Shingyy/MAC-Array-based-DNN-Accelerator/Activation Buffer/rtl_schematic/Ekran görüntüsü 2026-07-28 130544.png

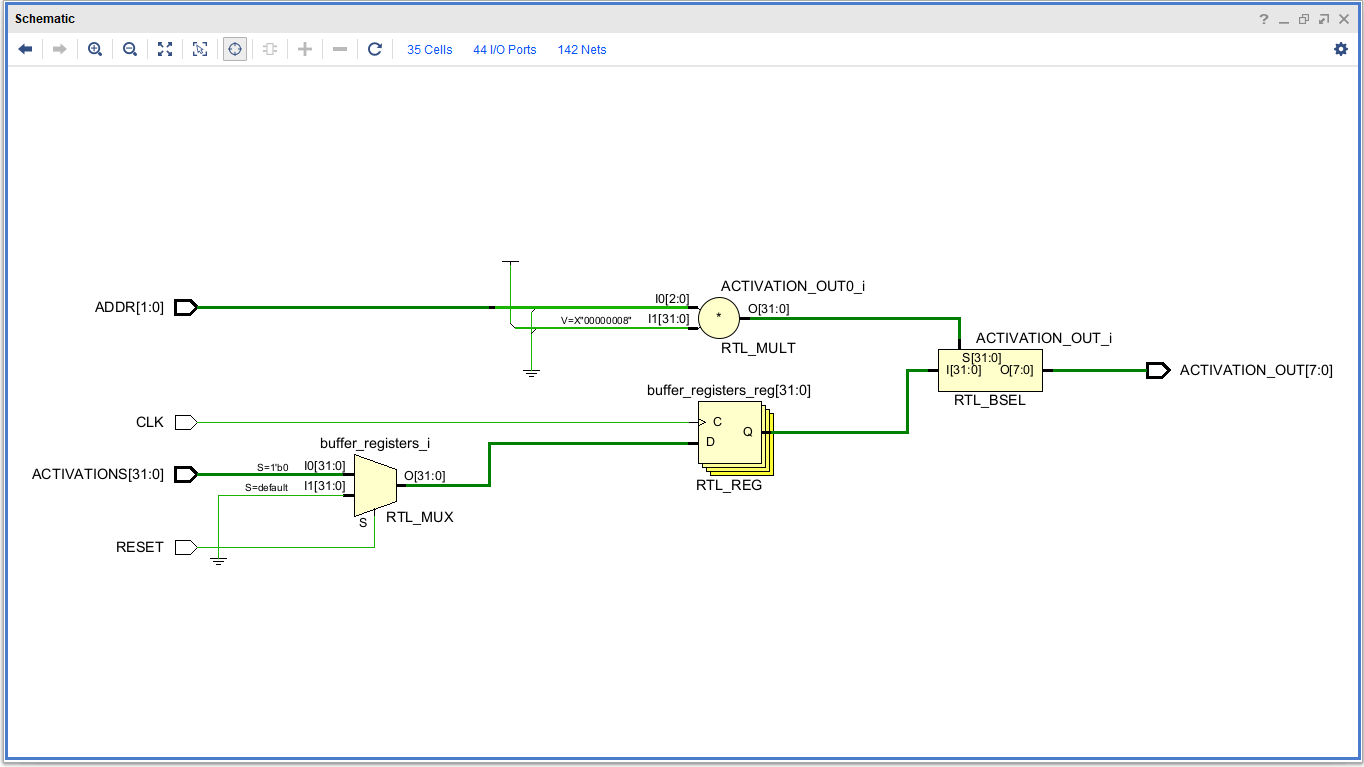
Activation Buffer/rtl_schematic/Ekran görüntüsü 2026-07-28 130544.png
