Shingyy/MAC-Array-based-DNN-Accelerator/Activation FIFO/rtl_schematic/Ekran görüntüsü 2026-07-28 144858.png

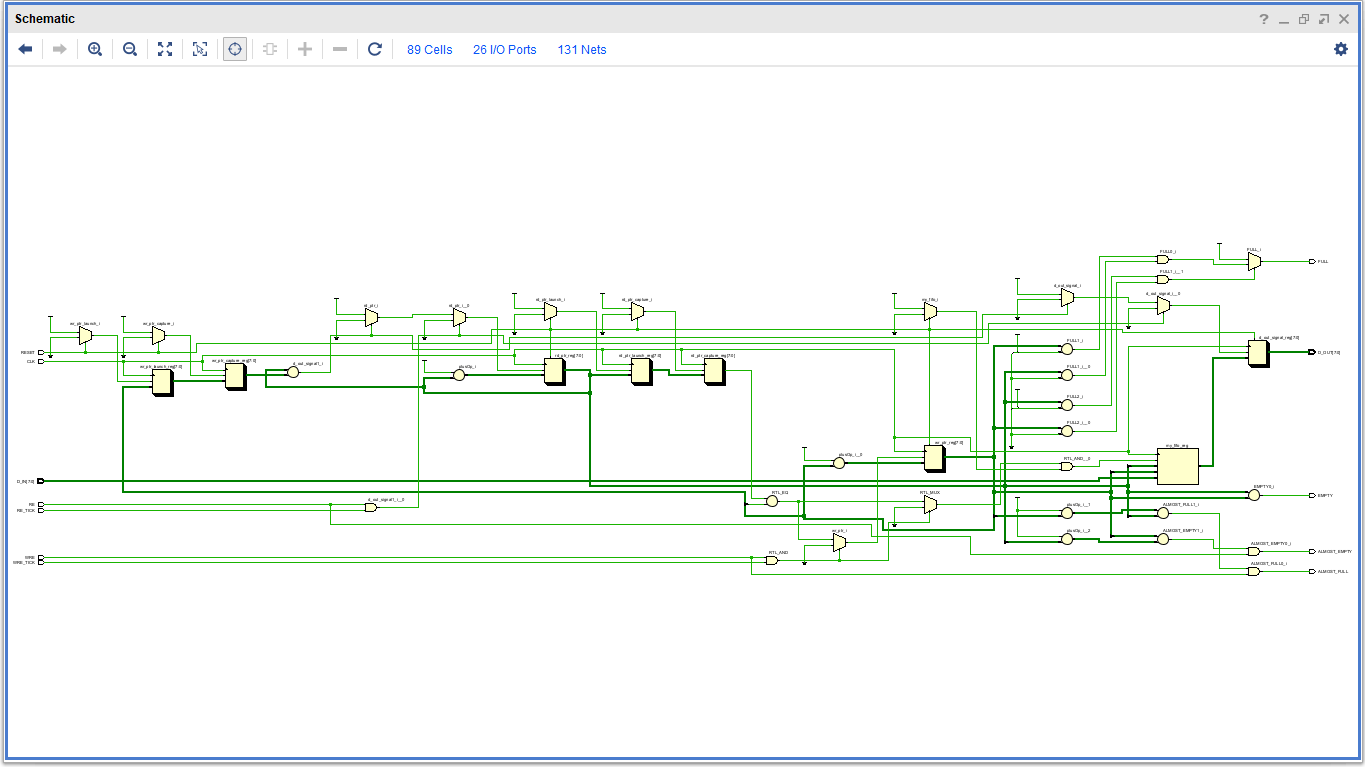
Activation FIFO/rtl_schematic/Ekran görüntüsü 2026-07-28 144858.png
