Shingyy/MAC-Array-based-DNN-Accelerator/Input Features Buffer/rtl_schematic/input_buffer_connected_to_MACU.png

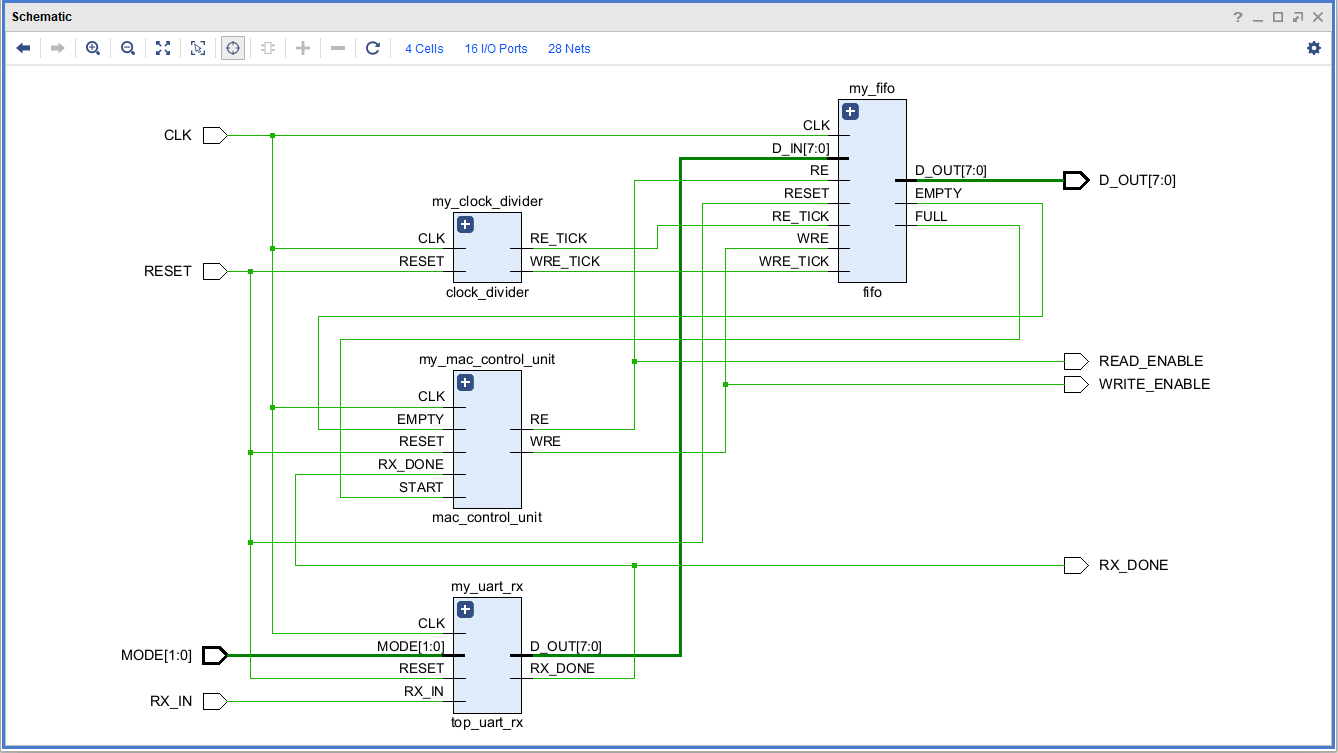
Input Features Buffer/rtl_schematic/input_buffer_connected_to_MACU.png
