Shingyy/MAC-Array-based-DNN-Accelerator/MAC Array Control Unit/state diagram/state diagram.jpeg

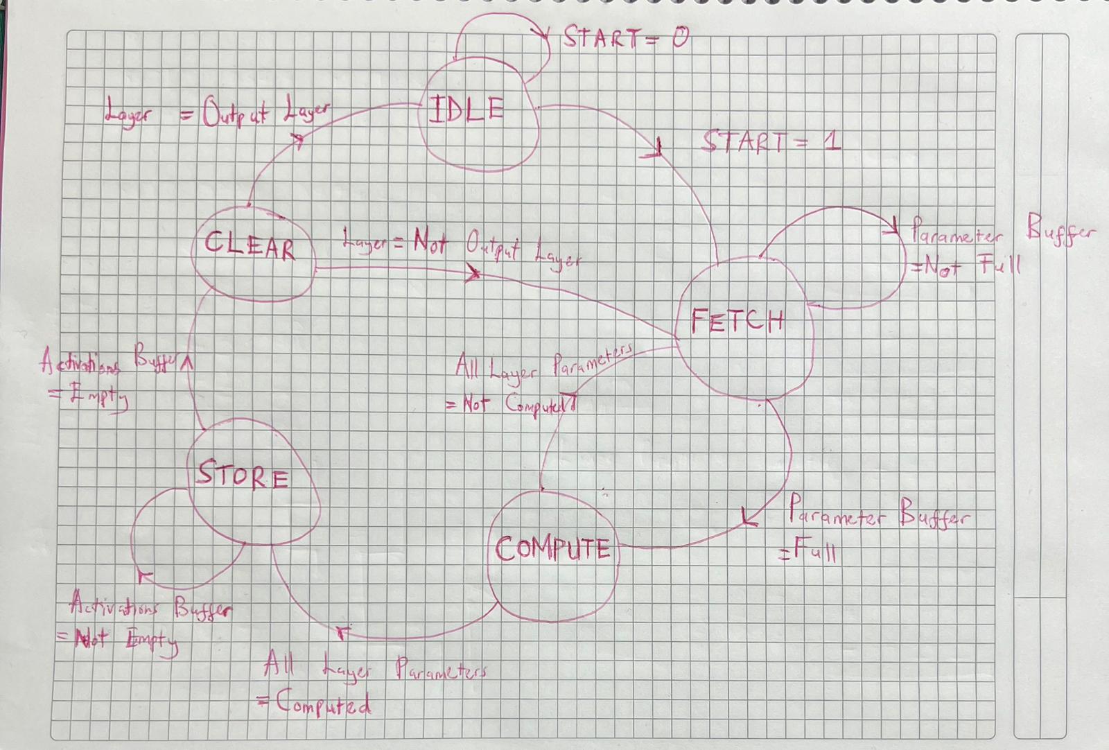
MAC Array Control Unit/state diagram/state diagram.jpeg
