Shingyy/MAC-Array-based-DNN-Accelerator/MAC Array/images/mac_array.png

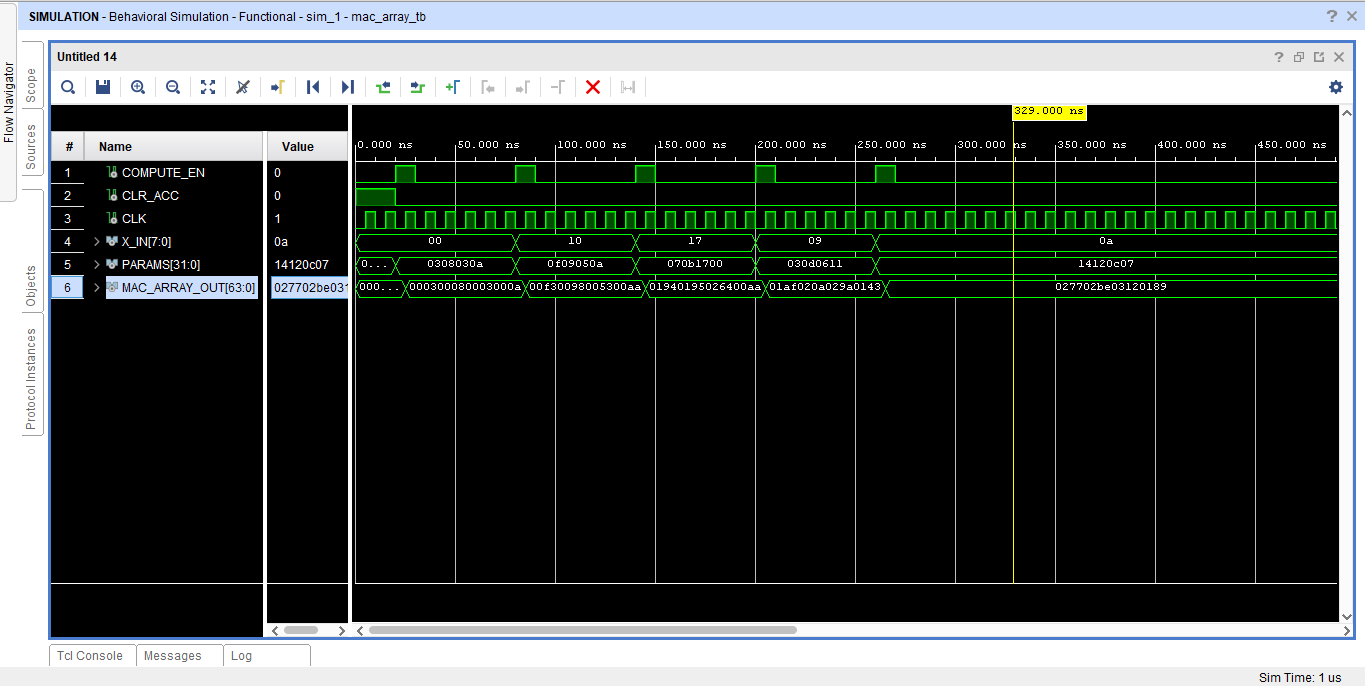
MAC Array/images/mac_array.png
