Shingyy/MAC-Array-based-DNN-Accelerator/MAC Array/rtl_schematic/mac_array_requantized.png

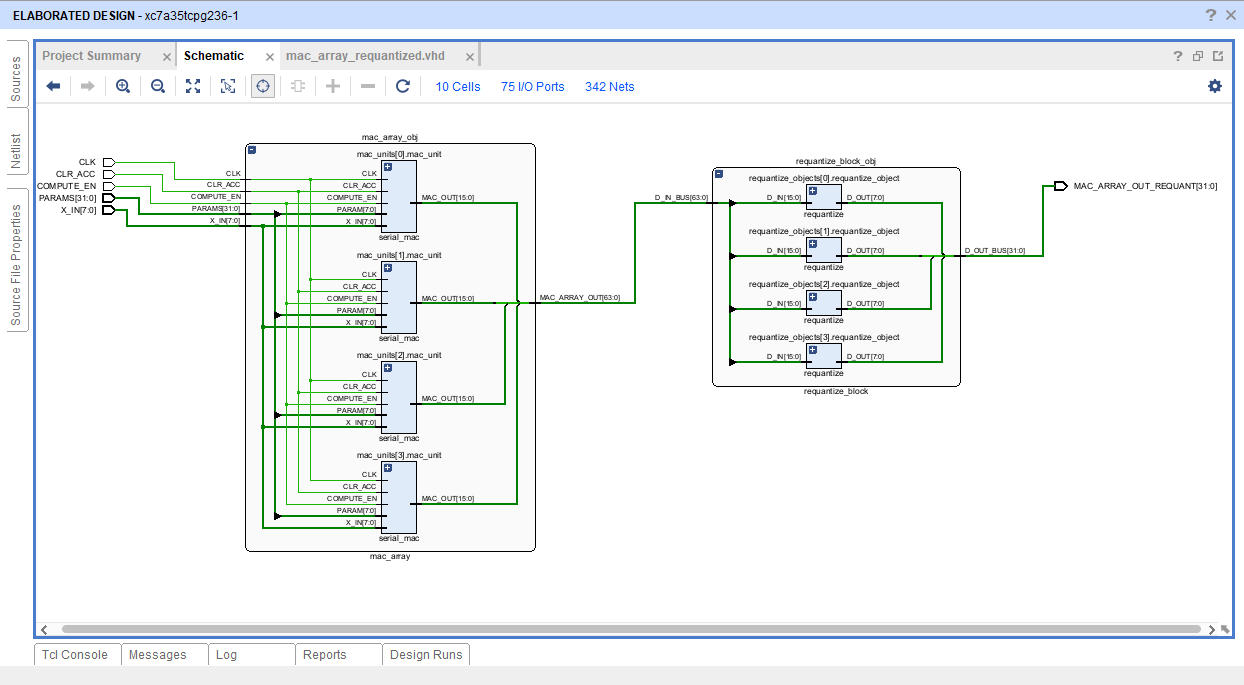
MAC Array/rtl_schematic/mac_array_requantized.png
