Shingyy/MAC-Array-based-DNN-Accelerator/MAC Array/rtl_schematic/serial_mac_unit.png

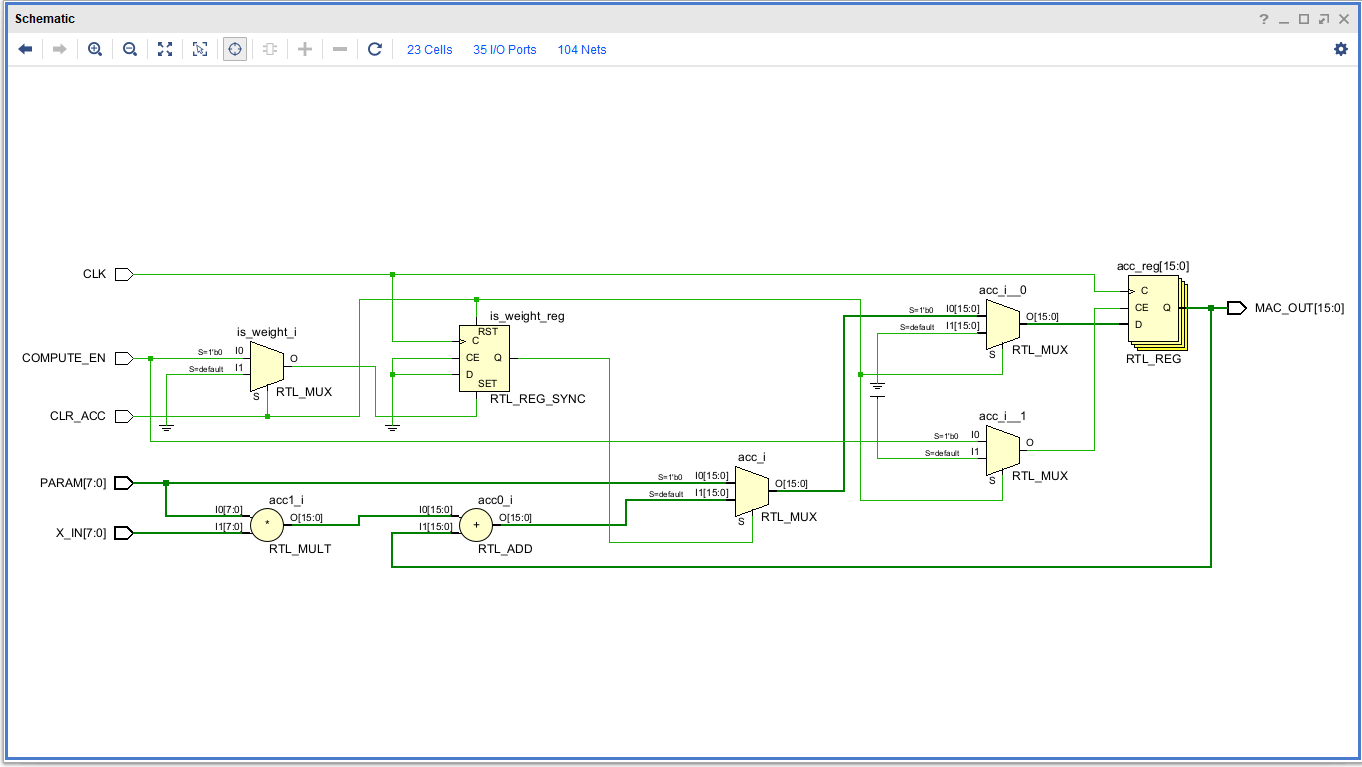
MAC Array/rtl_schematic/serial_mac_unit.png
