Shingyy/MAC-Array-based-DNN-Accelerator/MAC Array/sim/serial_mac.png

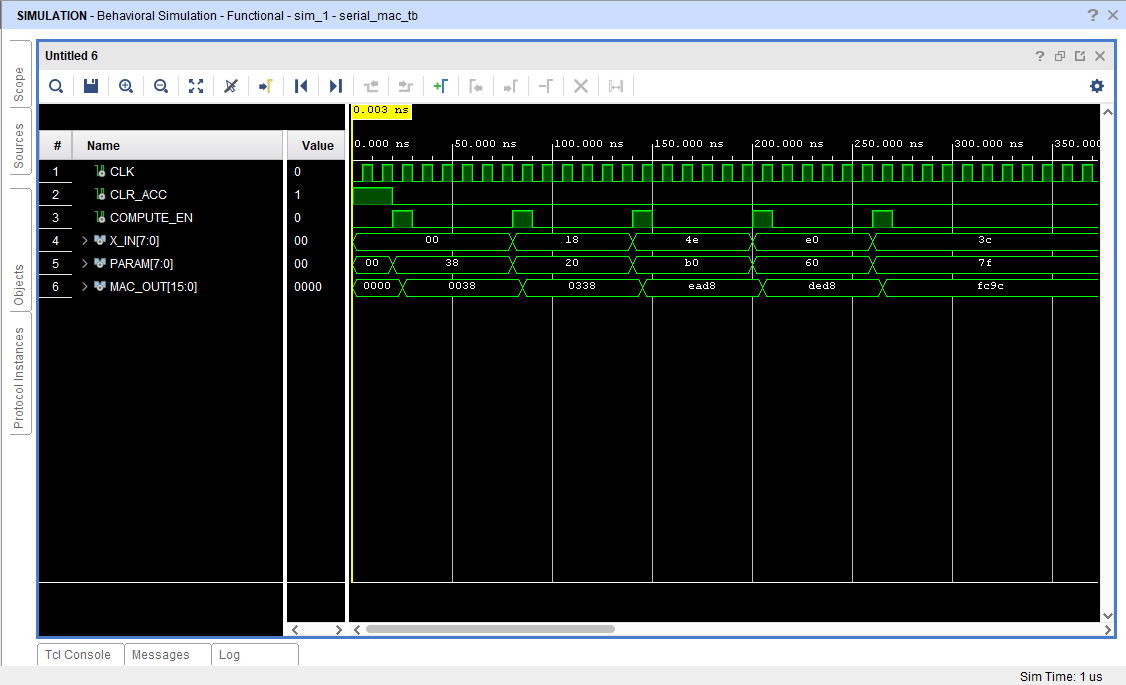
MAC Array/sim/serial_mac.png
