Shingyy/MAC-Array-based-DNN-Accelerator/Parameter Buffer/rtl_schematic/rtl_schematic.png

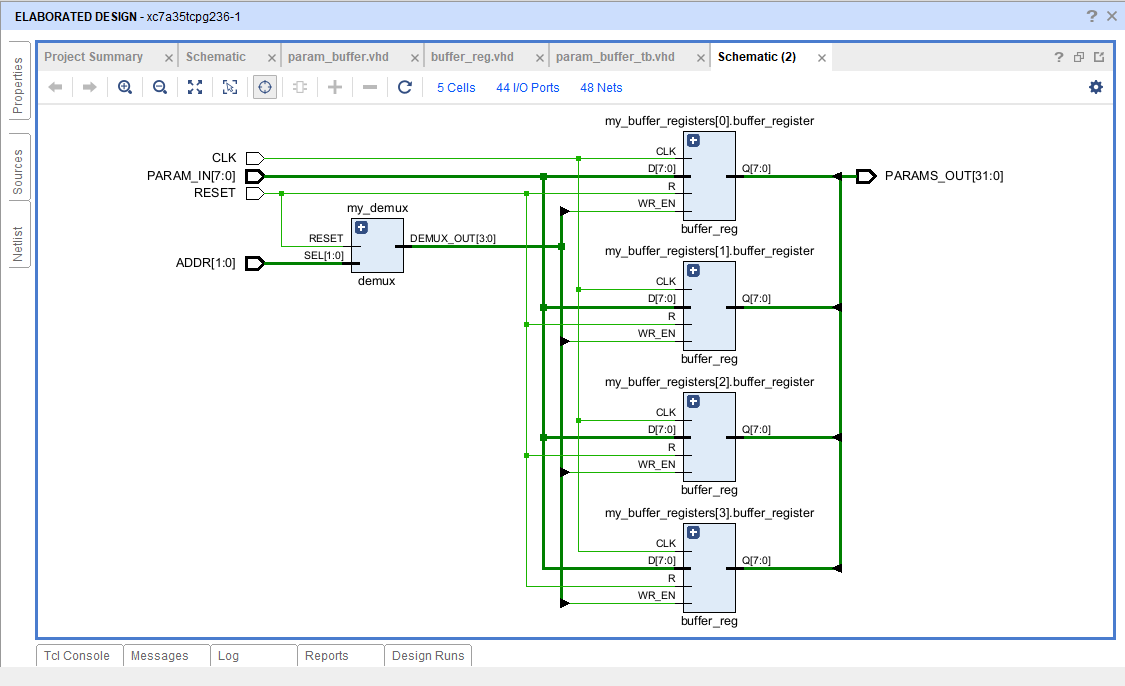
Parameter Buffer/rtl_schematic/rtl_schematic.png
