Shingyy/MAC-Array-based-DNN-Accelerator/ReLU and Argmax/rtl_schematic/argmax(input_side).png

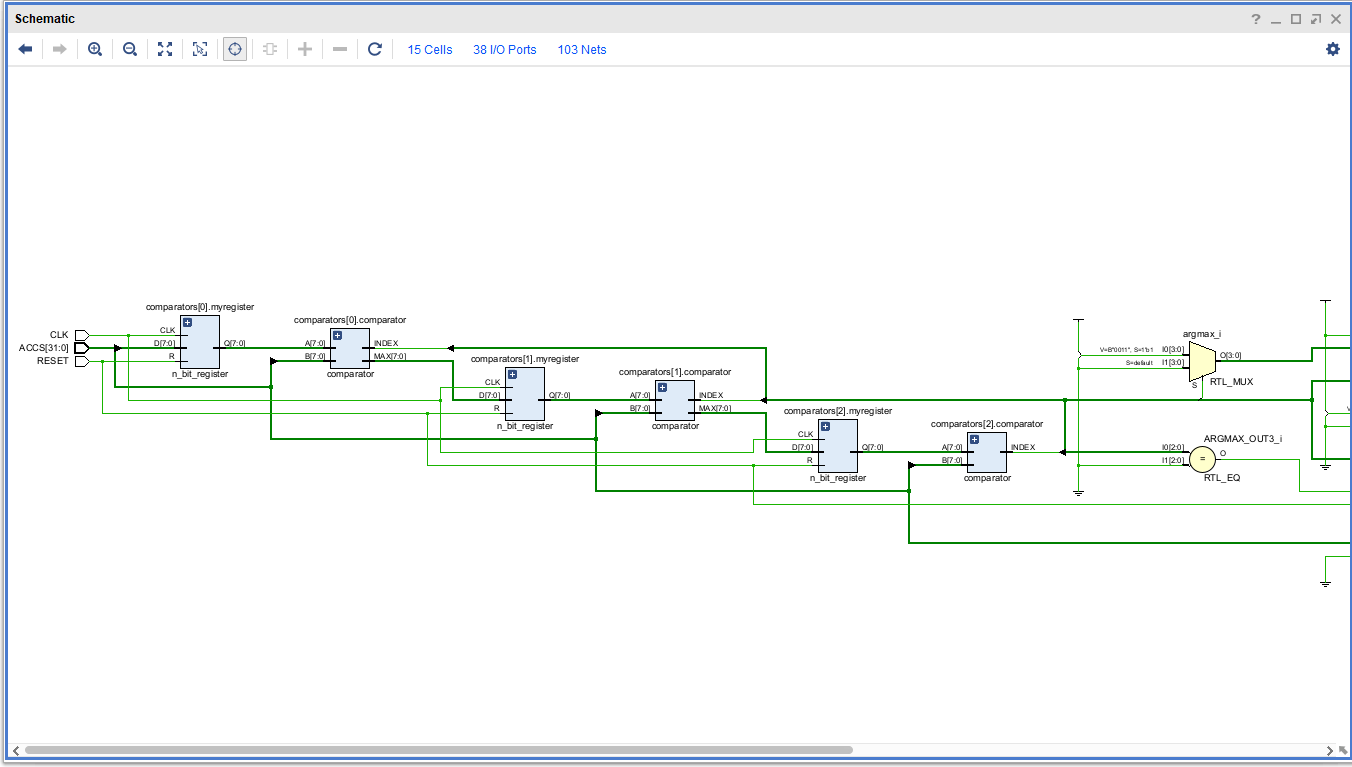
ReLU and Argmax/rtl_schematic/argmax(input_side).png
