Shingyy/MAC-Array-based-DNN-Accelerator/ReLU and Argmax/rtl_schematic/relu.png

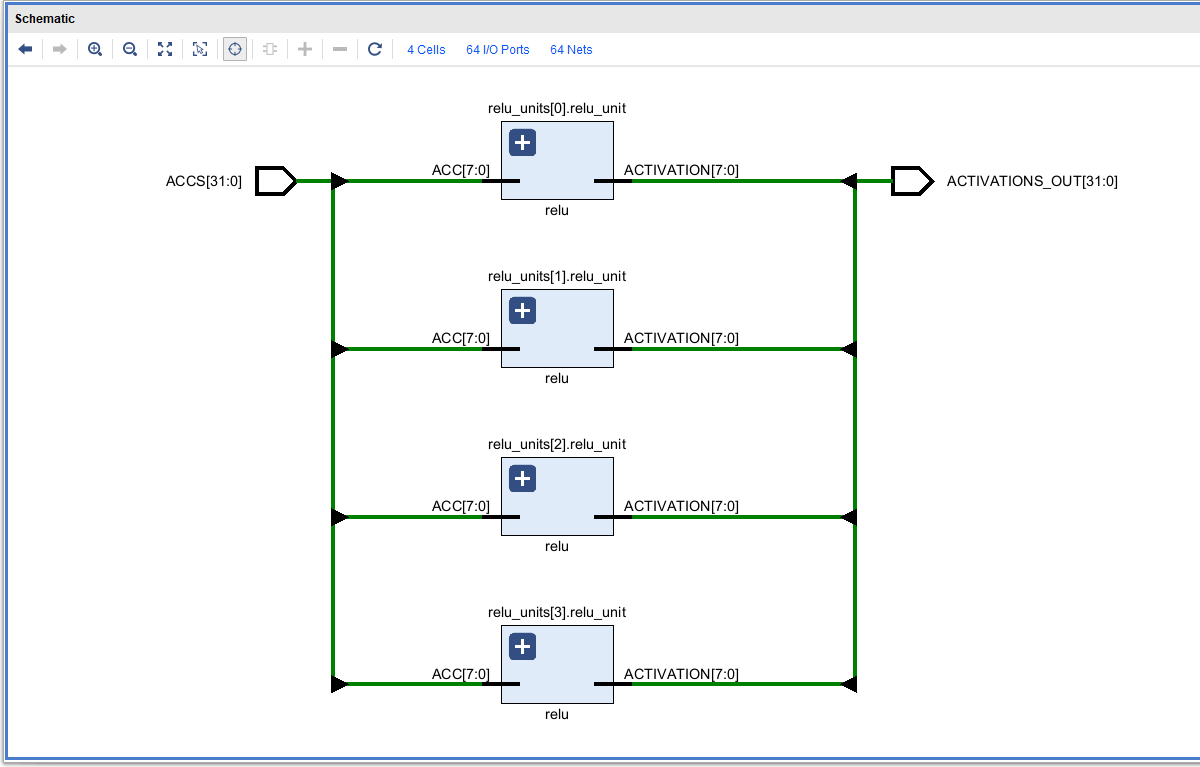
ReLU and Argmax/rtl_schematic/relu.png
