Shingyy/MAC-Array-based-DNN-Accelerator/Top Level Design/rtl_schematic/rtl schematic.png

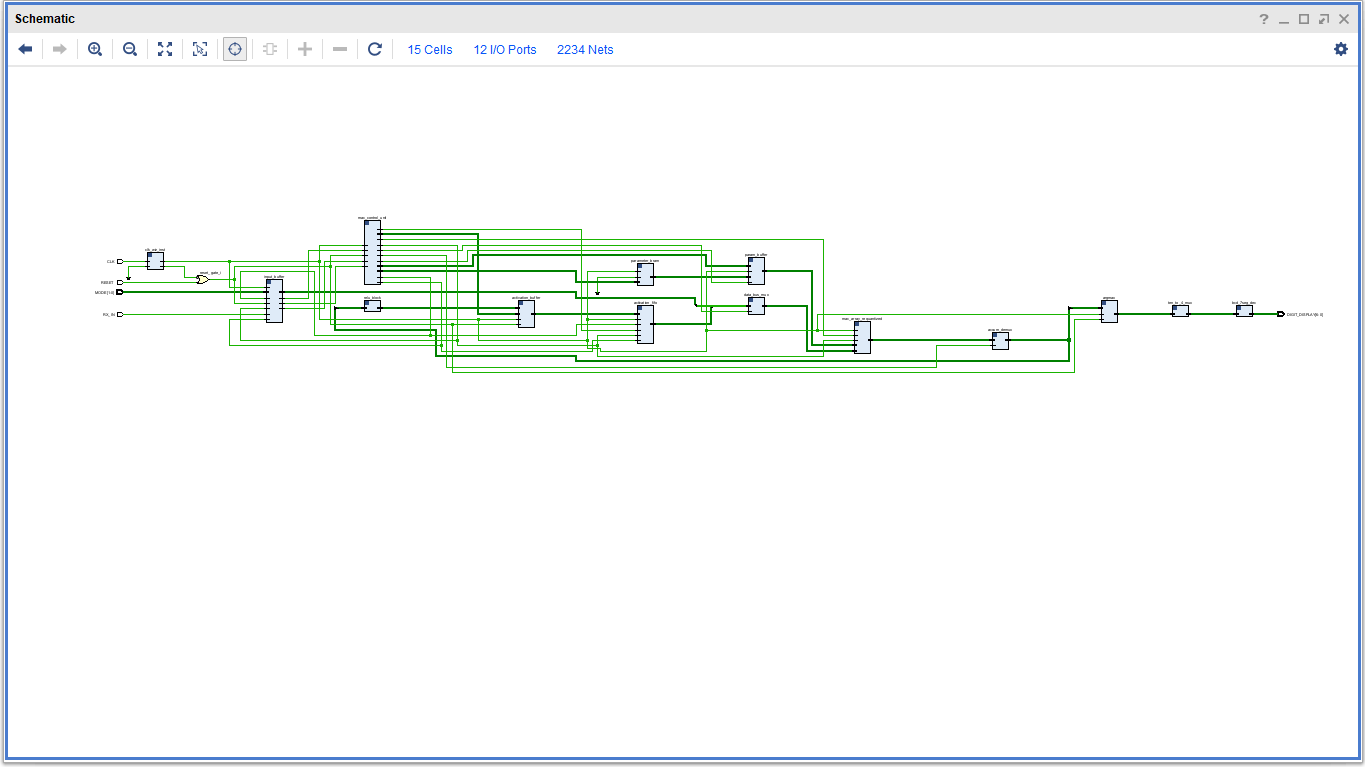
Top Level Design/rtl_schematic/rtl schematic.png
