Shingyy/MAC-Array-based-DNN-Accelerator/Input Features Buffer/src/mac_control_unit.vhd

library IEEE;
use IEEE.std_logic_1164.all;
use IEEE.numeric_std.all;

entity mac_control_unit is
    generic(
        input_vector_length: integer:= 2;
        N: integer:= 8;--bit width
        K: integer:= 3;-- 2**K MAC units
        X: integer:= 10;-- Parameter BRAM Address bit width
        N_layers: integer := 5;-- number of layers
        L1: integer:= 6;-- number of neurons for 1st layer
        L2: integer:= 5; -- number of layers for 2nd layer
        L3: integer:= 4;-- number of neurons for 3rd layer 
        L4: integer:= 3;-- number of neurons for 4th layer
        L5: integer:= 2-- number of neurons for output layer  
    );
    port (
        CLK: in std_logic;
        RESET: in std_logic;
        START: in std_logic;--driven by the FIFO FULL signal
        RX_DONE: in std_logic;
        EMPTY: in std_logic;-- driven by the FIFO EMPTY signal
        PARAM_SRC: out std_logic_vector(X-1 downto 0);--Paramater BRAM
        PARAM_DEST: out std_logic_vector(K-1 downto 0);--Parameter Buffer
        ACTIVATION_SRC: out std_logic_vector(K-1 downto 0); --Activations Buffer
        COMPUTE_EN: out std_logic;--Compute enable signal for the MAC ARRAY
        CLR_ACC: out std_logic;-- Clear Accumulator signal for the MAC Array
        OL: out std_logic;--Output Layer Flag
        IL: out std_logic;-- Input Layer Flag
        RE: out std_logic;-- read enable signal for FIFO
        WRE: out std_logic; --write enable signal for FIFO
        PARAM_BUFFER_RESET: out std_logic;
        ACTIVATION_FIFO_RESET: out std_logic-- reset for activation FIFO
    );
end entity mac_control_unit;

architecture rtl of mac_control_unit is
    signal dist_counter: unsigned(K-1 downto 0);-- distribution counter
    signal param_counter: unsigned(X-1 downto 0);
    signal compute_cycle: unsigned(X-1 downto 0);
    signal layer: unsigned(2 downto 0);--current layer being computed
    signal activation_en,param_en: std_logic;--enabling distribution counter to either param DEMUX or Activation MUX 
    type STATES is (IDLE, FETCH, COMPUTE, STORE, CLEAR);
    signal current_state : STATES;
    signal param_delay: std_logic;
    signal base_addr: unsigned(X-1 downto 0);
    signal activation_delay: unsigned(1 downto 0);
    type neural_network is array(0 to 4) of unsigned(K downto 0);
    type activations is array(0 to 4) of unsigned(X-1 downto 0);
    constant activation_structure: activations:= (
        0=> to_unsigned(input_vector_length,X),
        1=> to_unsigned(L1,X),
        2=> to_unsigned(L2, X),
        3=> to_unsigned(L3,X),
        4=> to_unsigned(L4,X)
    );
    constant NEURAL_NET_TOPOLOGY: neural_network:= (
        0=> to_unsigned(L1,K+1),
        1=> to_unsigned(L2,K+1),
        2=> to_unsigned(L3,K+1),
        3=> to_unsigned(L4,K+1),
        4=> to_unsigned(L5,K+1)
    );
     signal neurons_per_layer: neural_network := NEURAL_NET_TOPOLOGY;
     signal activations_per_layer:activations := activation_structure;
begin
    sync_process: process (CLK) is
    begin
        if rising_edge(CLK) then
            if RESET= '1' then
                dist_counter<= to_unsigned(0,K);
                param_counter<= to_unsigned(0,X);
                compute_cycle<= to_unsigned(1,X);
                base_addr<= to_unsigned(1,X);
                layer<= to_unsigned(0,3);
                current_state<= IDLE;
                COMPUTE_EN<= '0';
                CLR_ACC<= '1';
                activation_en<= '0';
                param_en<= '1';
                param_delay<= '0';
                activation_delay<= "00";
                RE<= '0';
                WRE<= '0';
                ACTIVATION_FIFO_RESET<= '1';--reset Activation FIFO
                PARAM_BUFFER_RESET<= '1'; --reset Paramater Buffer Registers
            else
                case current_state is
                    when IDLE =>
                        dist_counter<= to_unsigned(0,K);
                        param_counter<= to_unsigned(0,X);
                        compute_cycle<= to_unsigned(1,X);
                        COMPUTE_EN<= '0';
                        CLR_ACC<= '0';
                        activation_en<= '0';
                        param_en<= '1';
                        param_delay<= '0';
                        activation_delay<= "00";
                        if RX_DONE= '1' and START= '0' then 
                            RE<= '0';
                            WRE<= '1';--start writing input features into FIFO
                        end if;
                        if RX_DONE= '0' and START= '0' then 
                            WRE<= '0';
                        end if;
                        if START= '1' and RX_DONE= '0' then 
                            RE<= '1';--start reading input features from FIFO
                            WRE<= '0';
                            current_state<= FETCH;--move to next state
                        end if;
                    when FETCH =>
                        PARAM_BUFFER_RESET<= '0';
                        CLR_ACC<= '0';
                        COMPUTE_EN<= '0';
                        if dist_counter< neurons_per_layer(to_integer(layer)) -1 then
                            --add 1 cycle delay to the distribution counter only to account for BRAM 1 cycle read latency
                            --parameter destination address has to align with the moment the parameter is read from BRAM
                            if param_delay= '1' then
                                dist_counter <= dist_counter + to_unsigned(1,K);
                            else
                                param_delay<= '1';
                            end if;
                        --ensure param counter only gets 2**K cycles despite the dist counter delay
                        --parameter counter keeps running and is not affected by the delay
                            if param_counter< base_addr + (neurons_per_layer(to_integer(layer)) -1 )*(activations_per_layer(to_integer(layer))+1) -1 then 
                            --parameter counter keeps running and is not affected by the delay
                                param_counter<= param_counter+ activations_per_layer(to_integer(layer))+1; -- jump to the address of the batch parameter of the next neuron
                            end if;
                        else
                            current_state<= COMPUTE;-- move to next state
                        end if;    
                    when COMPUTE =>
                        COMPUTE_EN<= '1';
                        param_delay<= '0';
                        compute_cycle<= compute_cycle + to_unsigned(1,N);
                        base_addr<= base_addr + to_unsigned(1,N);
                        dist_counter<= to_unsigned(0,K);
                        if compute_cycle < activations_per_layer(to_integer(layer)) +1 then
                            param_counter<= base_addr;
                            current_state<= FETCH;
                        else
                            PARAM_BUFFER_RESET<= '1';
                            param_en<= '0';
                            activation_en<= '1';
                            RE<= '0';
                            ACTIVATION_FIFO_RESET<= '1';--reset ACTIVATION FIFO before writing new values
                            current_state<= STORE;
                        end if;
                    when STORE=> 
                        ACTIVATION_FIFO_RESET<= '0';
                        param_en<= '0';
                        activation_en<= '1';
                        COMPUTE_EN<= '0';
                        if dist_counter< neurons_per_layer(to_integer(layer)) -1 then
                            if activation_delay< to_unsigned(3,2) then
                                activation_delay<= activation_delay+ to_unsigned(1,2);
                                if activation_delay= to_unsigned(2,2) then
                                    WRE<= '1';
                                    RE<= '0'; 
                                end if ;
                            else
                                dist_counter <= dist_counter + to_unsigned(1,K);
                            end if;
                        else
                            WRE<= '0';
                            layer<= layer + 1;--setting up next layer transition
                            current_state<= CLEAR;
                        end if;
                    when CLEAR=>
                        if layer< to_unsigned(N_layers,3) then
                            CLR_ACC<= '1';
                            compute_cycle<= to_unsigned(1,X);
                            dist_counter<= (others=> '0');
                            param_en<= '1';
                            activation_en<= '0';
                            param_delay<= '0';
                            activation_delay<= "00";
                            RE<= '1'; --read from activations FIFO
                            param_counter<= param_counter+ to_unsigned(1,X);--set to parameter source address to the first bias of next layer 
                            base_addr<= param_counter + to_unsigned(2,X);-- base address set to parameter source address + 2
                            current_state<= FETCH;
                        else
                            current_state<= IDLE;
                        end if;
                end case;
            end if;
        end if;
    end process;
    PARAM_SRC<= std_logic_vector(param_counter);
    PARAM_DEST<= std_logic_vector(dist_counter) when param_en='1' else (others=> '0');
    ACTIVATION_SRC<= std_logic_vector(dist_counter) when activation_en='1' else (others=> '0');
    OL<= '1' when layer> to_unsigned(N_layers-1, 3) else  '0' ;--output layer flag
    IL<= '1' when layer= to_unsigned(0,3) else '0';--input layer flag
end architecture rtl;
